Spatia/idle-game-PCB/Graphismes/Background.png

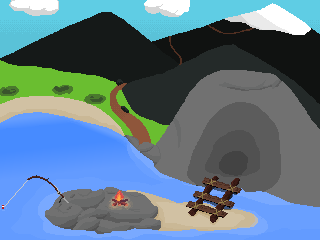
Graphismes/Background.png
