Spatia/idle-game-PCB/Idle_Game_PCB.csv

Reference | Qty | Value | DNP | Exclude from BOM | Exclude from Board | Footprint | Datasheet
BT1 | 1 | Battery_Cell |  |  |  | Connector_JST:JST_PH_S2B-PH-K_1x02_P2.00mm_Horizontal
C1,C16,C20,C21,C22,C23,C24 | 7 | 100nF |  |  |  | Capacitor_SMD:C_0805_2012Metric_Pad1.18x1.45mm_HandSolder
C2,C3 | 2 | 8pF |  |  |  | Capacitor_SMD:C_0805_2012Metric_Pad1.18x1.45mm_HandSolder
C4,C5 | 2 | 18pF |  |  |  | Capacitor_SMD:C_0805_2012Metric_Pad1.18x1.45mm_HandSolder
C6,C18,C19 | 3 | 10uF |  |  |  | Capacitor_SMD:C_0805_2012Metric_Pad1.18x1.45mm_HandSolder
C7,C8,C9,C10,C12 | 5 | 100nF |  |  |  | Capacitor_SMD:C_0603_1608Metric_Pad1.08x0.95mm_HandSolder
C11 | 1 | 2u2 |  |  |  | Capacitor_SMD:C_0603_1608Metric_Pad1.08x0.95mm_HandSolder
C13 | 1 | 1uF |  |  |  | Capacitor_SMD:C_0603_1608Metric_Pad1.08x0.95mm_HandSolder
C14 | 1 | 10nF |  |  |  | Capacitor_SMD:C_0603_1608Metric_Pad1.08x0.95mm_HandSolder
C15,C17 | 2 | 1uF |  |  |  | Capacitor_SMD:C_0805_2012Metric_Pad1.18x1.45mm_HandSolder
F1 | 1 | Polyfuse |  |  |  | Library:1812L010DR
IC1 | 1 | MCP1827S-3302E_EBVAO |  |  |  | Library:MCP1827S3302EEBVAO | https://ww1.microchip.com/downloads/aemDocuments/documents/APID/ProductDocuments/DataSheets/MCP1827-Data-Sheet-DS20002001.pdf
J1 | 1 | FH12A-50S-0.5SH_55_ |  |  |  | Library:FH1250S05SH55_Mirrored | https://www.hirose.com/product/download/?distributor=digikey&type=2d&lang=en&num=FH12A-50S-0.5SH(55)
J2 | 1 | PSP_ADA_444 |  |  |  | Library:PSPADA444
J3 | 1 | FTSH-107-01-L-DV-K-A |  |  |  | Library:FTSH-107-XX-YYY-DV-K-A | http://suddendocs.samtec.com/prints/ftsh-1xx-xx-xxx-dv-xxx-xxx-mkt.pdf
P1 | 1 | USB_C_Plug_USB2.0 |  |  |  | Library:USB_Receptacle | https://www.usb.org/sites/default/files/documents/usb_type-c.zip
Q1,Q2,Q5 | 3 | BSS138 |  |  |  | Package_TO_SOT_SMD:SOT-23 | https://www.onsemi.com/pub/Collateral/BSS138-D.PDF
Q3,Q4 | 2 | NTR4171PT1G |  |  |  | Package_TO_SOT_SMD:SOT-23 | https://www.onsemi.com/pub/Collateral/FDN340P-D.PDF
R1 | 1 | 10kR |  |  |  | Resistor_SMD:R_0805_2012Metric
R2,R3,R4,R6,R7,R8,R9,R10,R11,R12,R13,R17,R21,R22,R32,R33,R34 | 17 | 10kR |  |  |  | Resistor_SMD:R_0805_2012Metric_Pad1.20x1.40mm_HandSolder
R5,R23,R24,R25,R26 | 5 | 0R |  |  |  | Resistor_SMD:R_0805_2012Metric_Pad1.20x1.40mm_HandSolder
R14,R15,R35 | 3 | 5.1kR |  |  |  | Resistor_SMD:R_0805_2012Metric_Pad1.20x1.40mm_HandSolder
R16 | 1 | 2.2kR |  |  |  | Resistor_SMD:R_0805_2012Metric_Pad1.20x1.40mm_HandSolder
R18,R19 | 2 | 10kR |  |  |  | Resistor_SMD:R_0603_1608Metric_Pad0.98x0.95mm_HandSolder
R20 | 1 | 100kR |  |  |  | Resistor_SMD:R_0805_2012Metric_Pad1.20x1.40mm_HandSolder
R27,R28,R29,R30 | 4 | 50R |  |  |  | Resistor_SMD:R_0805_2012Metric_Pad1.20x1.40mm_HandSolder
R31 | 1 | 100R |  |  |  | Resistor_SMD:R_0805_2012Metric_Pad1.20x1.40mm_HandSolder
S1,S2,S3,S4,S5,S6,S7,S8 | 8 | PTS645SH43SMTR92_LFS |  |  |  | Library:PTS645SH43SMTR92LFS | https://www.ckswitches.com/media/1471/pts645.pdf
S9 | 1 | 1825910-6 |  |  |  | Library:18259106 | https://www.ckswitches.com/media/1471/pts645.pdf
TP1 | 1 | VBAT |  |  |  | TestPoint:TestPoint_Pad_D2.0mm
TP2 | 1 | 3V3 |  |  |  | TestPoint:TestPoint_Pad_D2.0mm
TP3 | 1 | GND |  |  |  | TestPoint:TestPoint_Pad_D2.0mm
U1 | 1 | STM32F401RETx |  |  |  | Package_QFP:LQFP-64_10x10mm_P0.5mm | https://www.st.com/resource/en/datasheet/stm32f401re.pdf
U2 | 1 | W25Q128JVS |  |  |  | Package_SO:SOIC-8_5.3x5.3mm_P1.27mm | https://www.winbond.com/resource-files/w25q128jv_dtr%20revc%2003272018%20plus.pdf
U3 | 1 | BQ24075RGT |  |  |  | Package_DFN_QFN:VQFN-16-1EP_3x3mm_P0.5mm_EP1.6x1.6mm | http://www.ti.com/lit/ds/symlink/bq24075.pdf
Y1 | 1 | ECS-120-8-33-JGN-TR |  |  |  | Library:ECS-120-8-33-JGN-TR_ECS | https://ecsxtal.com/store/pdf/ecx-32.pdf
Y3 | 1 | ECS-.327-12.5-16-TR3 |  |  |  | Library:ECS32712534RRTR | https://www.ecsxtal.com/store/pdf/ECX-16.pdf
