Spatia/idle-game-PCB/Lib_SPATIA-F4/3D/ER-TFT024-3-sans-nappe.stp

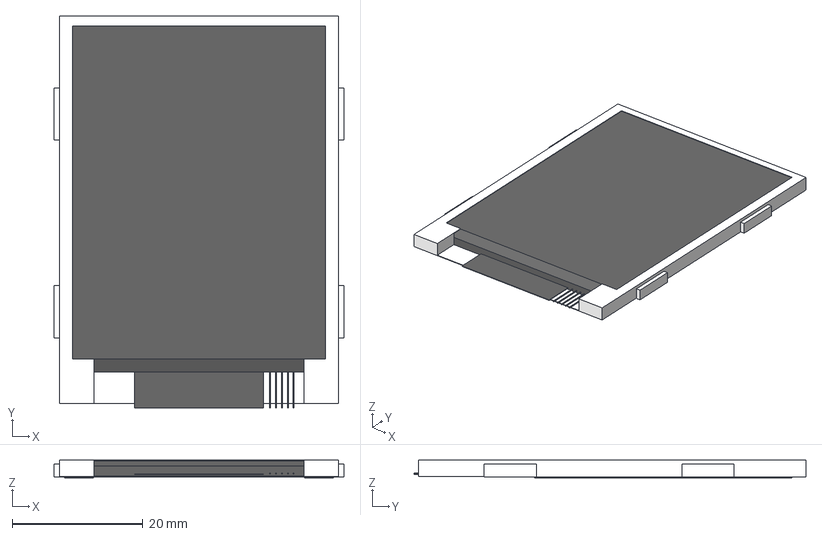
[picture p4: CAD file, 2026-08-21]
Lib_SPATIA-F4/3D/ER-TFT024-3-sans-nappe.stp
44.3 x 60.0 x 2.70 mm
\X2\00BF00C7\X0\
\X2\00BF00C7\X0\--1
\X2\00BF00C7\X0\--2
