Spatia/idle-game-PCB/Lib_SPATIA-F4/3D/jumper.stp

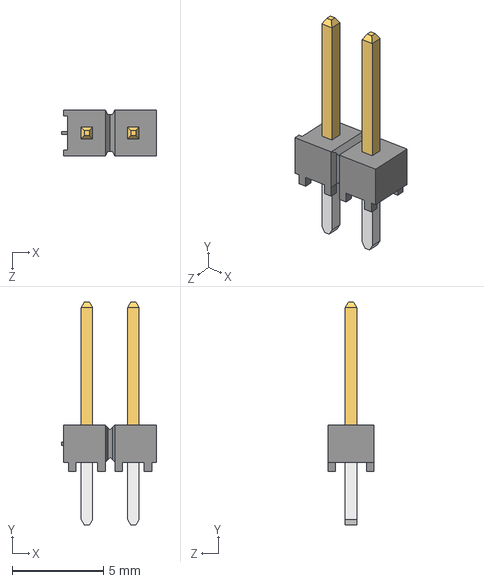
[picture p5: CAD file, 2026-08-21]
Lib_SPATIA-F4/3D/jumper.stp
5.21 x 12.2 x 2.54 mm
T-1S6-17-TSW-1-24-2-S
TSW-102-24-L-S_body
