Spatia/idle-game-PCB/Lib_SPATIA-F4/3D/FH12A-50S-0.5SH_55_.stp

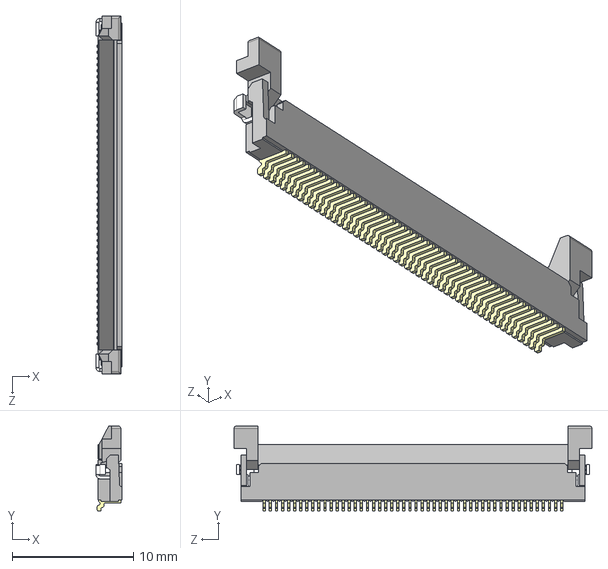
[picture p6: CAD file, 2026-08-21]
Lib_SPATIA-F4/3D/FH12A-50S-0.5SH_55_.stp
2.15 x 7.00 x 29.5 mm
