Spatia/idle-game-PCB/Lib_SPATIA-F4/3D/PTS645SM50-2_LFS.stp

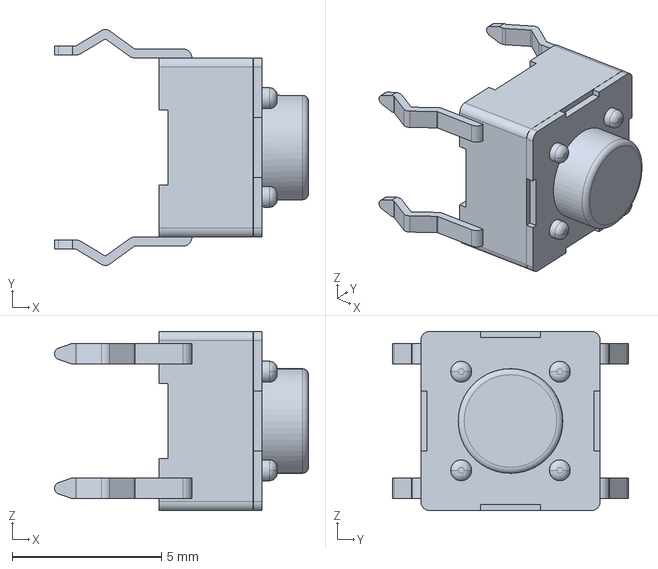
[picture p7: CAD file, 2026-08-21]
Lib_SPATIA-F4/3D/PTS645SM50-2_LFS.stp
8.50 x 7.90 x 6.00 mm
