Spatia/idle-game-PCB/Lib_SPATIA-F4/3D/FTSH-107-01-L-DV-K-A.stp

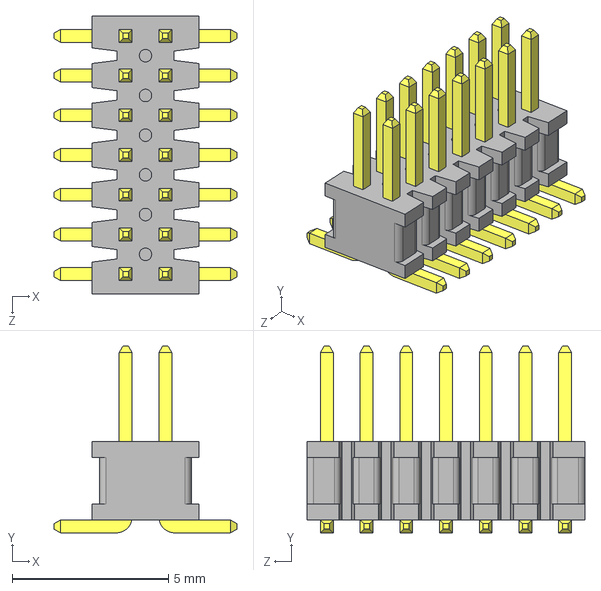
[picture p8: CAD file, 2026-08-21]
Lib_SPATIA-F4/3D/FTSH-107-01-L-DV-K-A.stp
5.84 x 5.97 x 8.89 mm
