Spatia/idle-game-PCB/Lib_SPATIA-F4/3D/CON_UFL001-SMD-T.stp

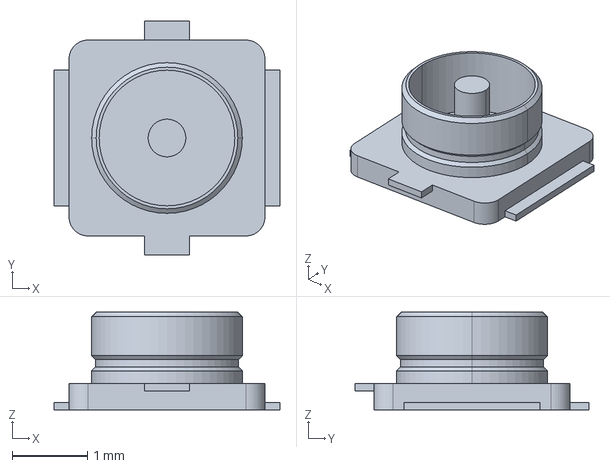
[picture p10: CAD file, 2026-08-21]
Lib_SPATIA-F4/3D/CON_UFL001-SMD-T.stp
3.00 x 3.10 x 1.30 mm
