Spatia/idle-game-PCB/Lib_SPATIA-F4/3D/ER-TFT024-3.stp

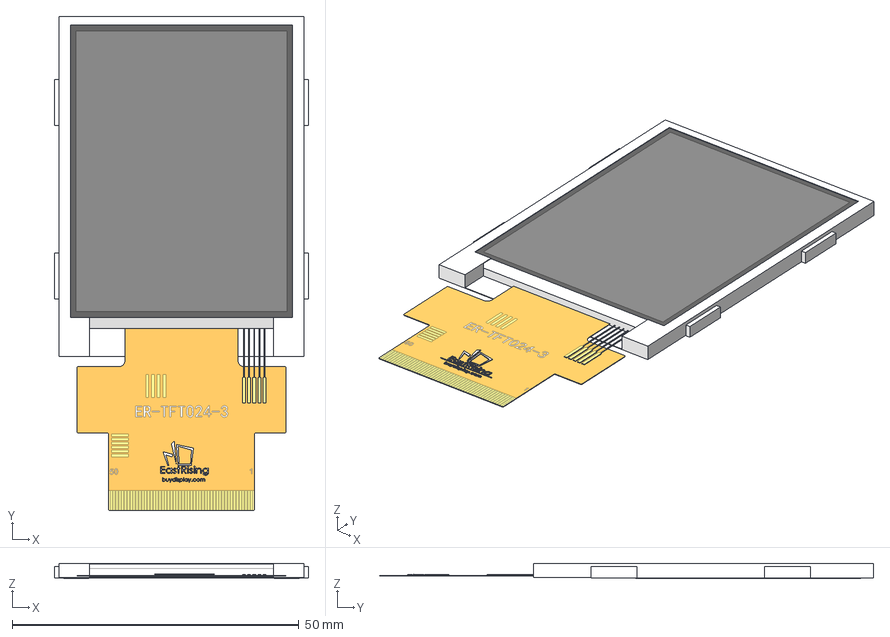
[picture p11: CAD file, 2026-08-21]
Lib_SPATIA-F4/3D/ER-TFT024-3.stp
44.3 x 86.2 x 2.70 mm
¿Ç
¿Ç--1
¿Ç--2
4no_1logo
4no_1logo--1
4no_1logo--2
4no_1logo--3
4no_1logo--4
4no_1logo--5
4no_1logo--6
4no_1logo--7
4no_1logo--8
4no_1logo--9
4no_1logo--10
4no_1logo--11
4no_1logo--12
4no_1logo--13
4no_1logo--14
4no_1logo--15
4no_1logo--16
4no_1logo--17
4no_1logo--18
4no_1logo--19
4no_1logo--20
4no_1logo--21
4no_1logo--22
4no_1logo--23
4no_1logo--24
4no_1logo--25
4no_1logo--26
4no_1logo--27
4no_1logo--28
4no_1logo--29
4no_1logo--30
ER-TFT024-3
