Spatia/idle-game-PCB/Lib_SPATIA-F4/3D/22-05-3041.stp

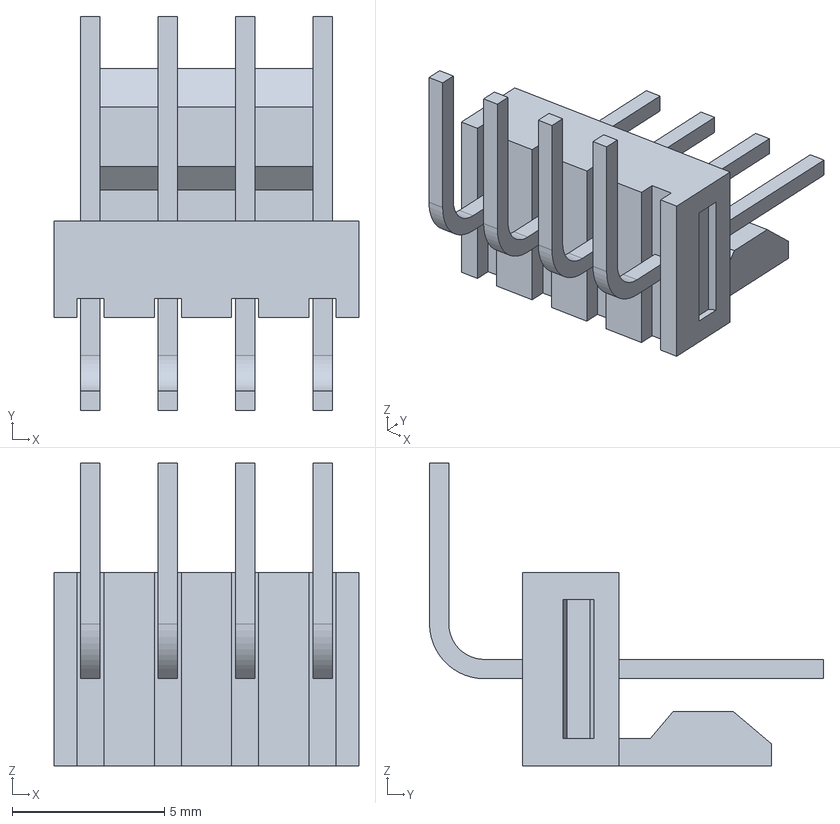
[picture p12: CAD file, 2026-08-21]
Lib_SPATIA-F4/3D/22-05-3041.stp
10.0 x 12.9 x 9.93 mm
