Spatia/idle-game-PCB/Lib_SPATIA-F4/3D/ECS-120-8-33-JGN-TR.stp

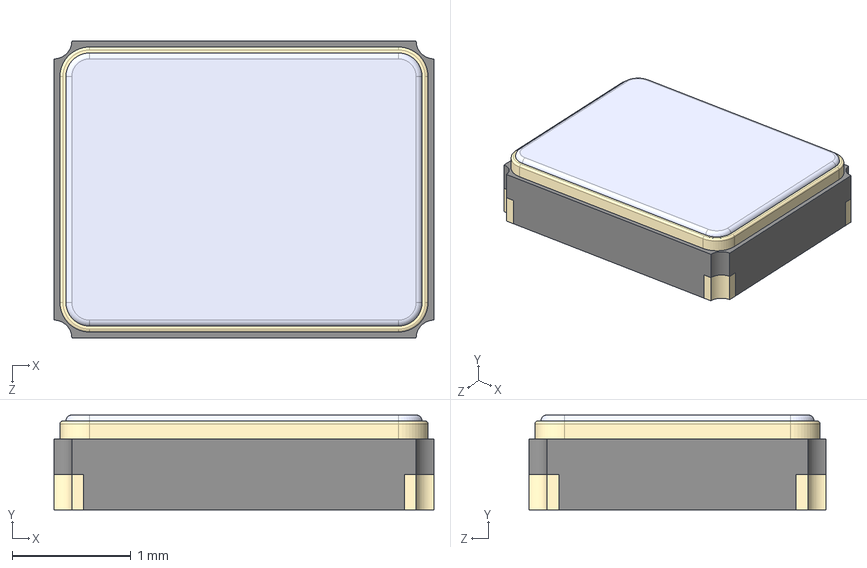
[picture p13: CAD file, 2026-08-21]
Lib_SPATIA-F4/3D/ECS-120-8-33-JGN-TR.stp
3.20 x 0.8 x 2.50 mm
