Spatia/idle-game-PCB/Lib_SPATIA-F4/3D/KP466PXTMA1.stp

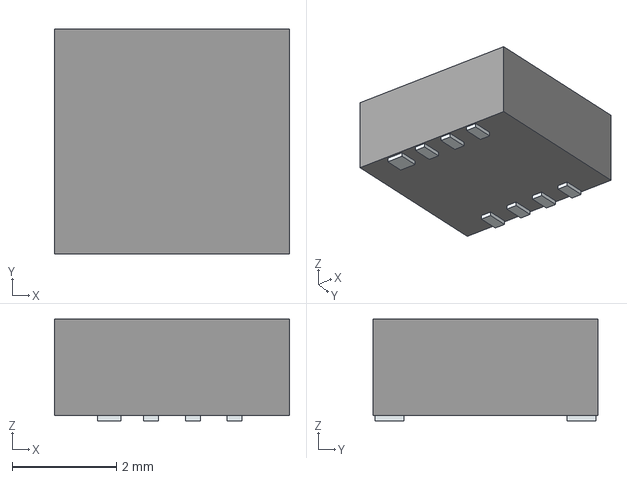
[picture p14: CAD file, 2026-08-21]
Lib_SPATIA-F4/3D/KP466PXTMA1.stp
4.50 x 4.30 x 1.95 mm
Pins
