Spatia/idle-game-PCB/Lib_SPATIA-F4/3D/ECS-.327-12.5-16-TR3.stp

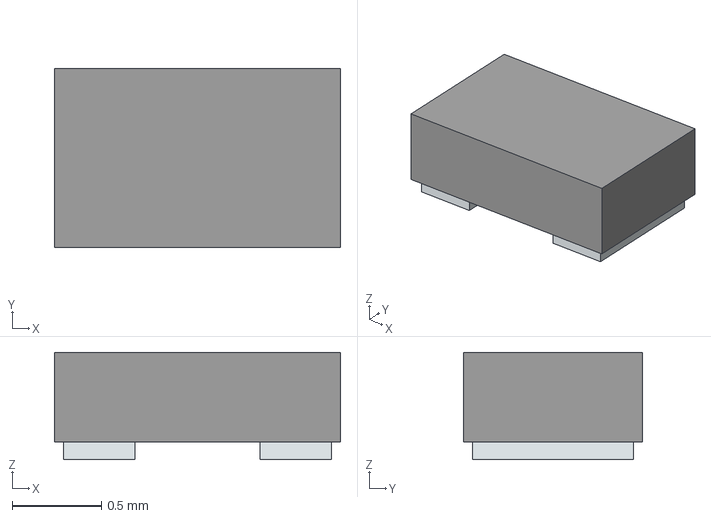
[picture p15: CAD file, 2026-08-21]
Lib_SPATIA-F4/3D/ECS-.327-12.5-16-TR3.stp
1.60 x 1.00 x 0.6 mm
Pins
