Spatia/idle-game-PCB/Lib_SPATIA-F4/3D/SMA_coude.stp

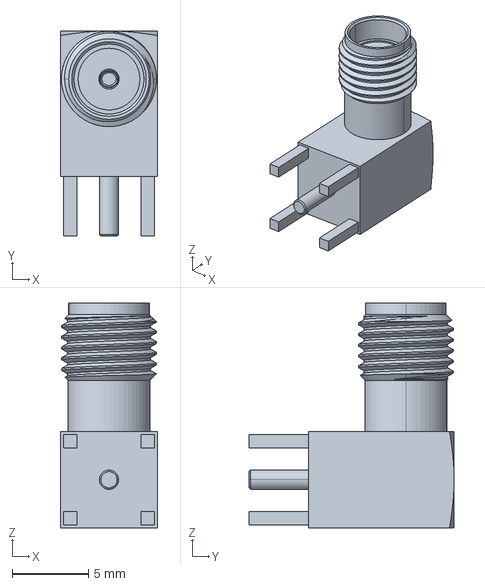
[picture p16: CAD file, 2026-08-21]
Lib_SPATIA-F4/3D/SMA_coude.stp
6.35 x 13.5 x 14.8 mm
