Spatia/idle-game-PCB/Lib_SPATIA-F4/3D/MCP1827S-3302E_EB.stp

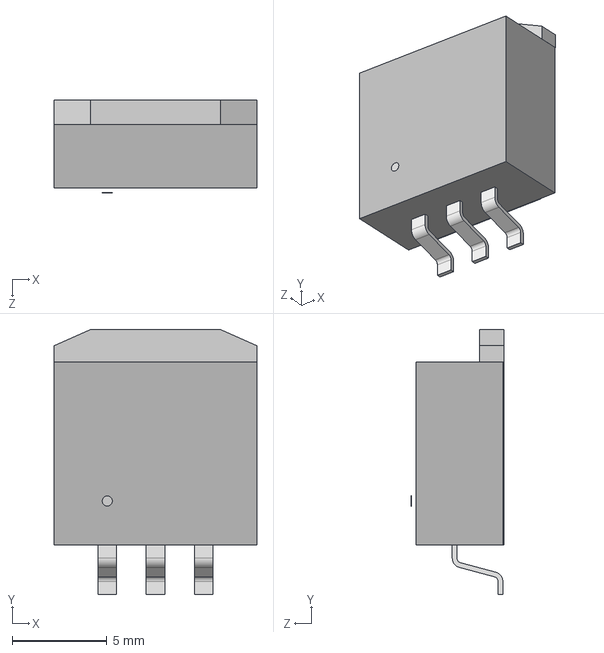
[picture p17: CAD file, 2026-08-21]
Lib_SPATIA-F4/3D/MCP1827S-3302E_EB.stp
10.7 x 14.0 x 4.88 mm
