Spatia/idle-game-PCB/Lib_SPATIA-F4/3D/ECS-.327-6-34RR-TR.stp

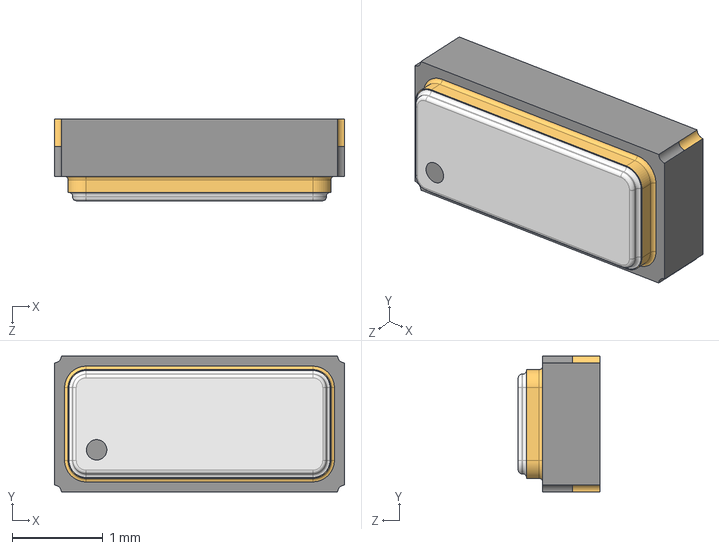
[picture p18: CAD file, 2026-08-21]
Lib_SPATIA-F4/3D/ECS-.327-6-34RR-TR.stp
3.20 x 1.50 x 0.9 mm
