Spatia/idle-game-PCB/Lib_SPATIA-F4/3D/USB4105-GF-A.stp

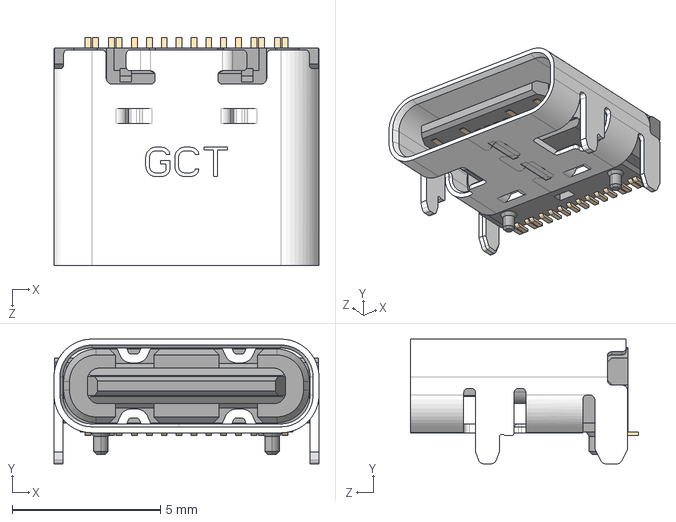
[picture p19: CAD file, 2026-08-21]
Lib_SPATIA-F4/3D/USB4105-GF-A.stp
8.94 x 4.21 x 7.70 mm
HSG_默认
