Spatia/idle-game-PCB/Lib_SPATIA-F4/3D/NTR4171PT1G.stp

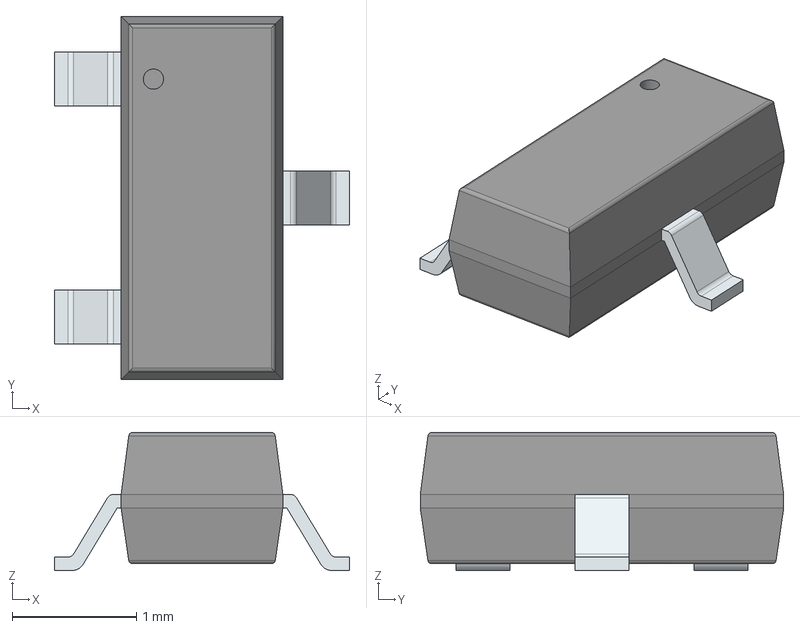
[picture p20: CAD file, 2026-08-21]
Lib_SPATIA-F4/3D/NTR4171PT1G.stp
2.37 x 2.92 x 1.11 mm
PinsArrayL
FilletPinR
