Spatia/idle-game-PCB/Lib_SPATIA-F4/3D/BAT54W-G3-18.stp

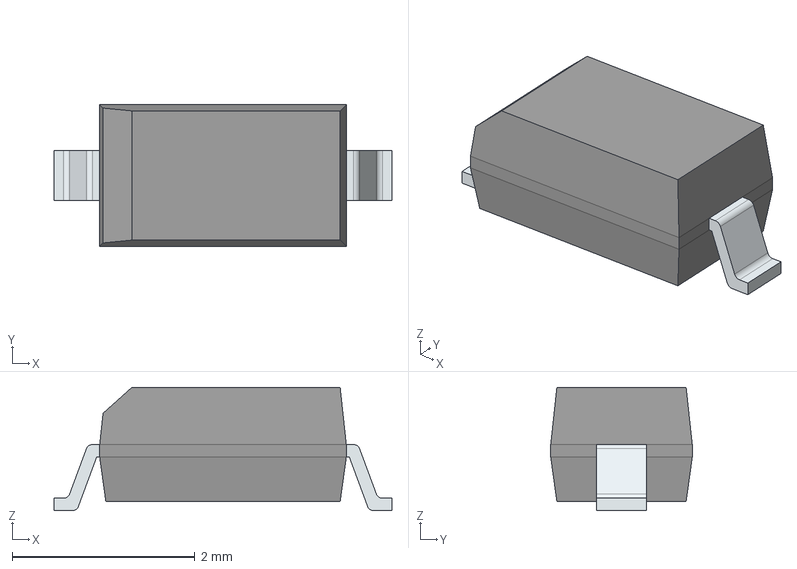
[picture p21: CAD file, 2026-08-21]
Lib_SPATIA-F4/3D/BAT54W-G3-18.stp
3.70 x 1.55 x 1.35 mm
FilletPinL
FilletPinR
