Spatia/idle-game-PCB/Lib_SPATIA-F4/3D/USB4085-GF-A.stp

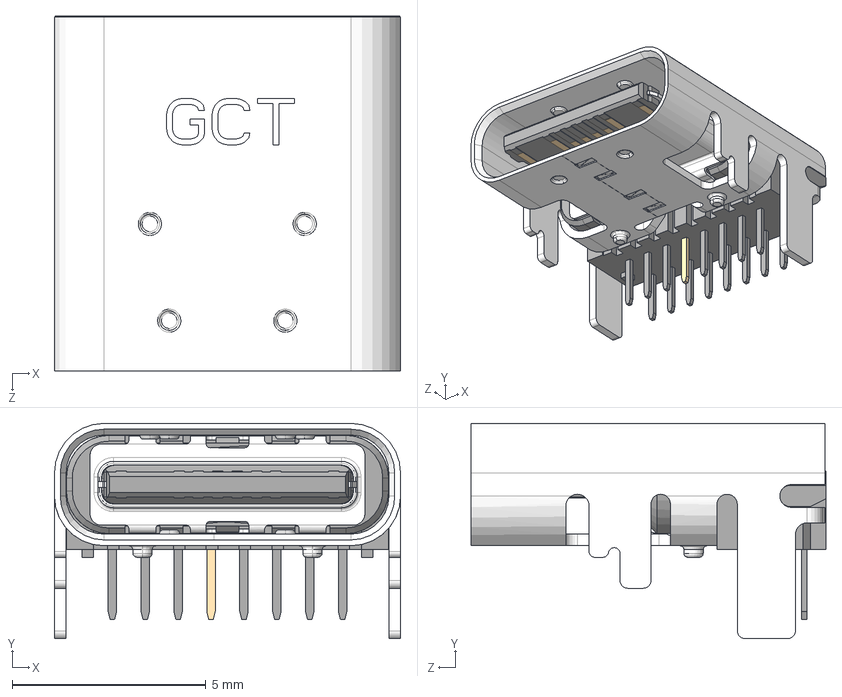
[picture p22: CAD file, 2026-08-21]
Lib_SPATIA-F4/3D/USB4085-GF-A.stp
8.94 x 5.56 x 9.17 mm
USB4085-GF-A_PART3
USB4085-GF-A_PART2
USB4085-GF-A_PART1
