Spatia/idle-game-PCB/Lib_SPATIA-F4/3D/PTS645SL70SMTR92_LFS.stp

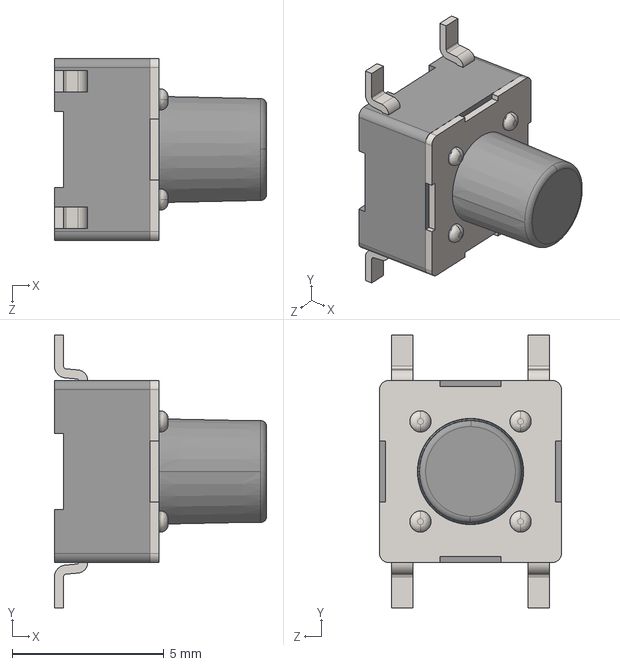
[picture p23: CAD file, 2026-08-21]
Lib_SPATIA-F4/3D/PTS645SL70SMTR92_LFS.stp
7.00 x 9.00 x 6.00 mm
