Spatia/idle-game-PCB/Lib_SPATIA-F4/3D/pile btn.stp

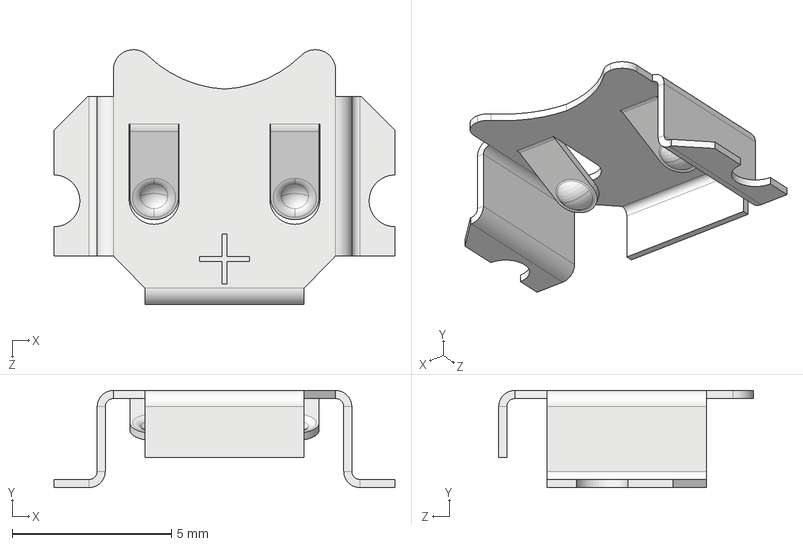
[picture p24: CAD file, 2026-08-21]
Lib_SPATIA-F4/3D/pile btn.stp
10.7 x 3.05 x 8.00 mm
