Spatia/idle-game-PCB/Lib_SPATIA-F4/3D/FH12-50S-0.5SH_55_.stp

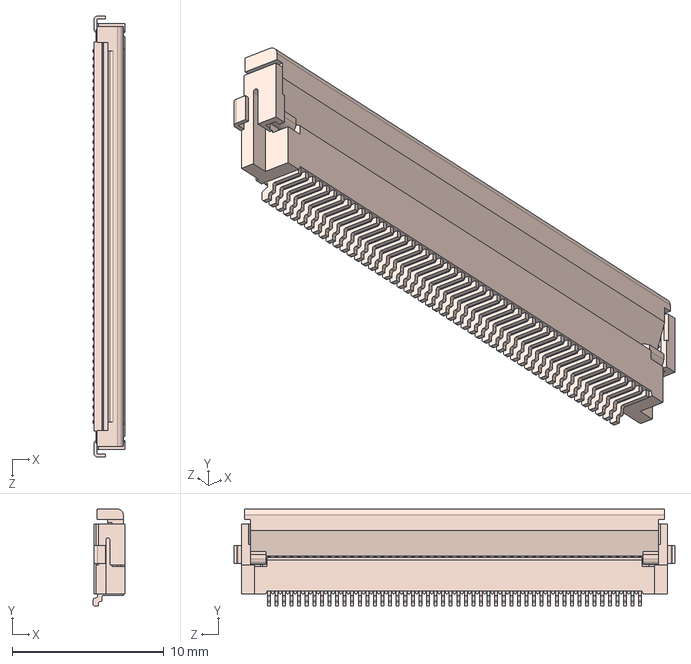
[picture p25: CAD file, 2026-08-21]
Lib_SPATIA-F4/3D/FH12-50S-0.5SH_55_.stp
2.10 x 6.40 x 29.1 mm
