Spatia/idle-game-PCB/(list of files, cad)

Other CAD files:
Lib_SPATIA-F4/3D/1812L260_16MR.stp
Lib_SPATIA-F4/3D/1825910-6.stp
Lib_SPATIA-F4/3D/53048-0810.stp
