Spatia/idle-game-PCB/Idle_Game_PCB.pdf

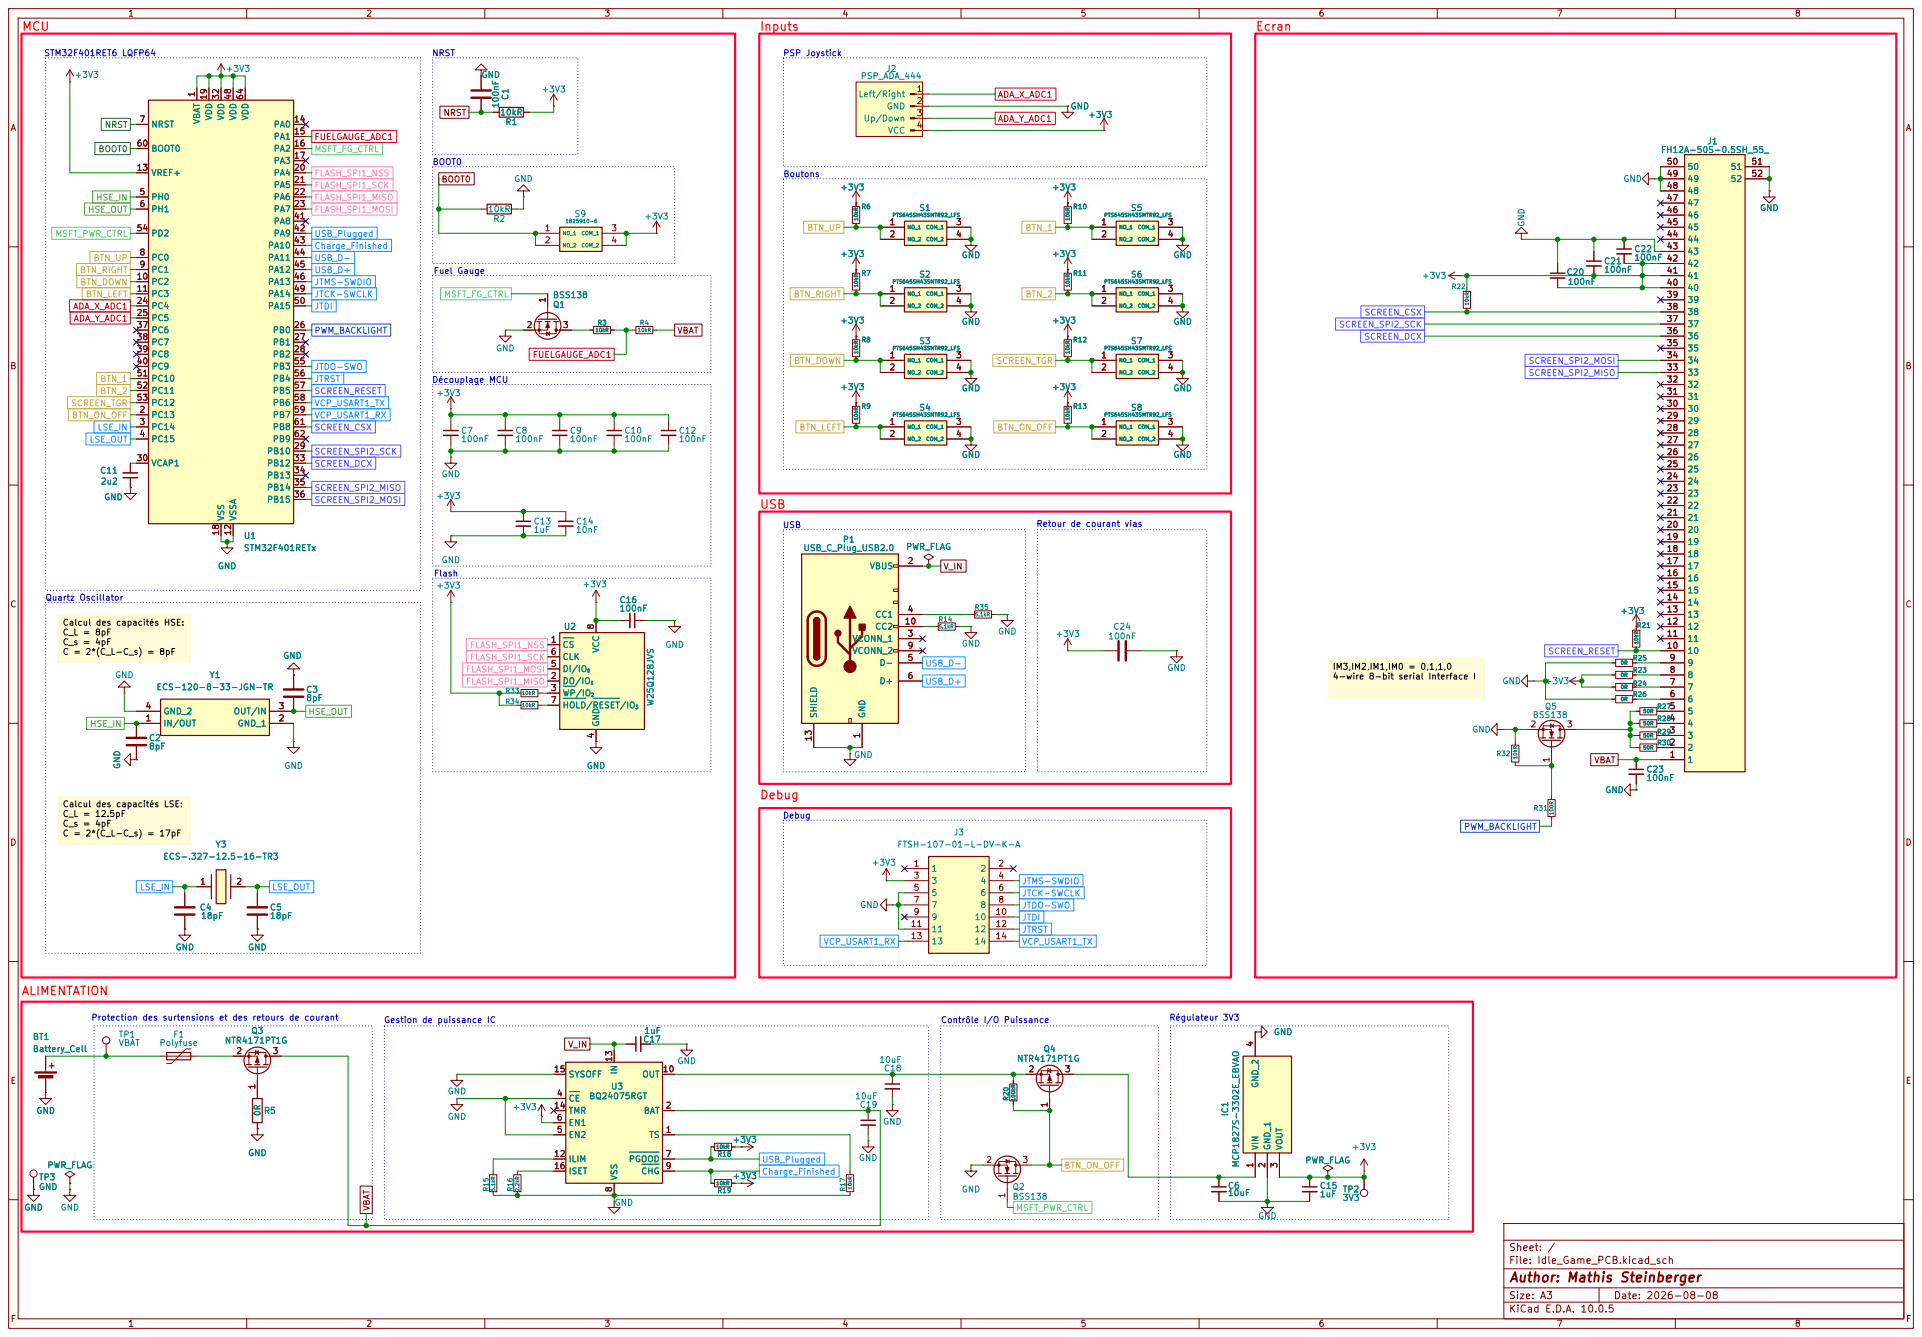
[picture p26: page 1]

Left/Right 1 GND 2 Up/Down 3

Retour de courant vias

4 DI/IO0 5 CLK 6 HOLD/RESET/IO3 7 VCC U2 8 W25Q128JVS +3V3 GND R16 2.2kR +3V3

4-wire 8-bit serial Interface I Calcul des capacités HSE: C_L = 8pF C_s = 4pF C = 2*(C_L-C_s) = 8pF Calcul des capacités LSE: C_L = 12.5pF C_s = 4pF C = 2*(C_L-C_s) = 17pF

4 DI/IO0 5 CLK 6 HOLD/RESET/IO3 7 VCC

Protection des surtensions et des retours de courant

Gestion de puissance IC
