Spatia/idle-game-PCB/Idle_Game_PCB.kicad_pcb

## KiCad design Idle_Game_PCB.kicad_pcb (2026-10-20)

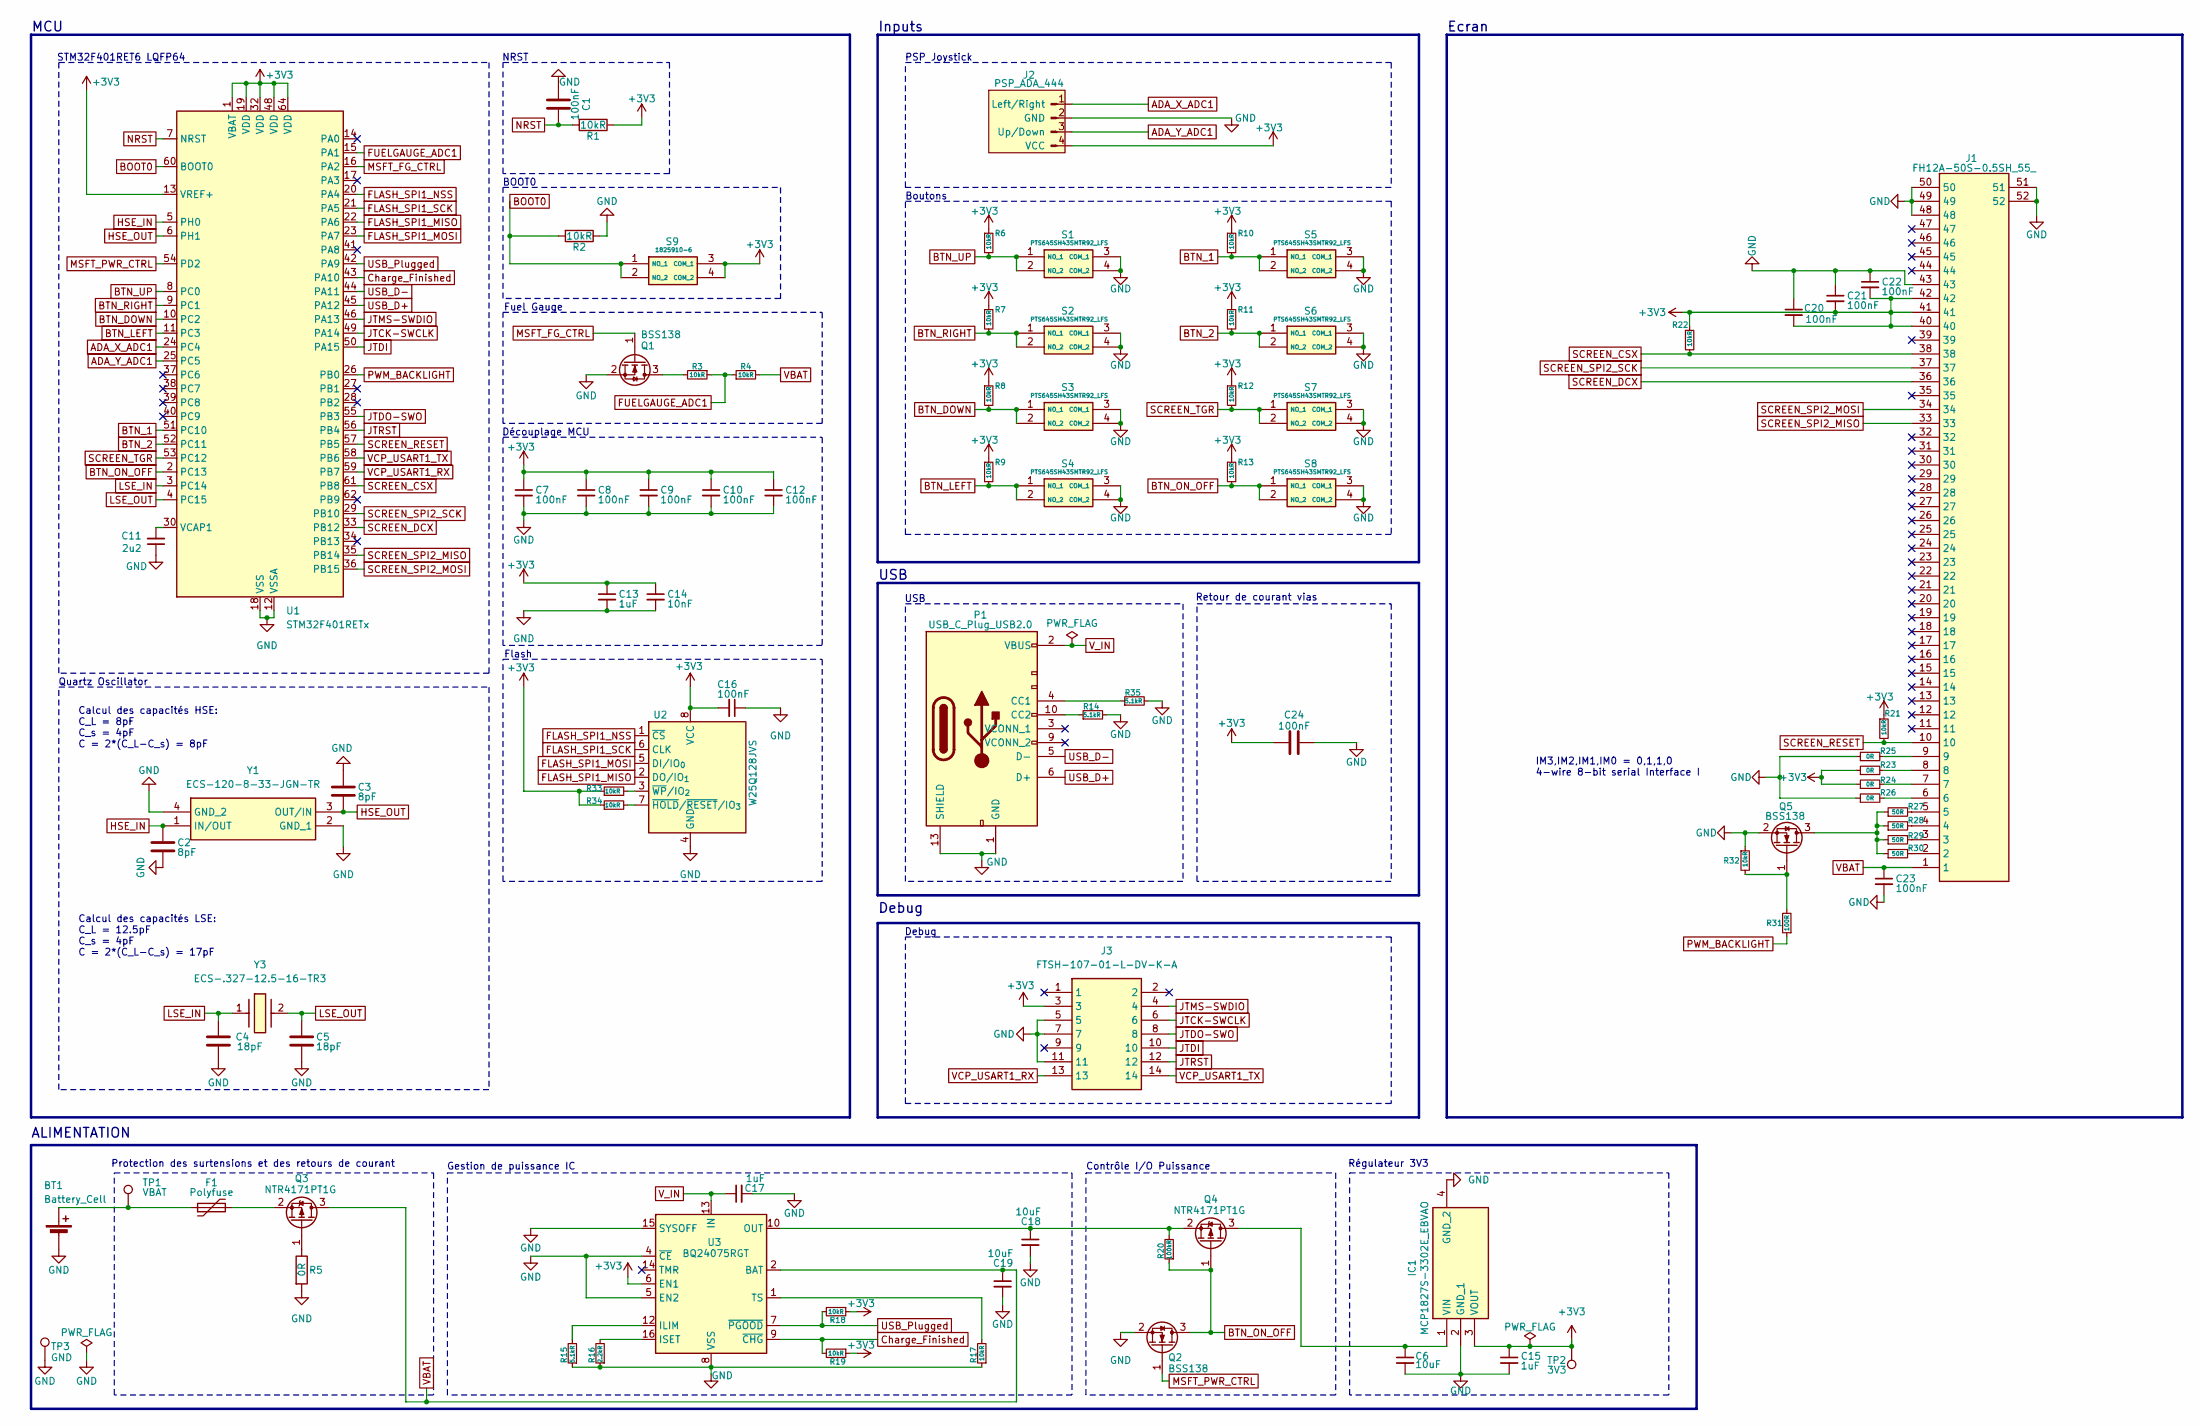
[picture p27: schematic Idle_Game_PCB.kicad_sch, Mathis Steinberger]

Parts:
BT1: Battery_Cell; JST_PH_S2B-PH-K_1x02_P2.00mm_Horizontal
C1, C16, C20, C21, C22, C23, C24: 100nF; C_0805_2012Metric_Pad1.18x1.45mm_HandSolder
C2, C3: 8pF; C_0805_2012Metric_Pad1.18x1.45mm_HandSolder
C4, C5: 18pF; C_0805_2012Metric_Pad1.18x1.45mm_HandSolder
C6, C18, C19: 10uF; C_0805_2012Metric_Pad1.18x1.45mm_HandSolder
C7, C8, C9, C10, C12: 100nF; C_0603_1608Metric_Pad1.08x0.95mm_HandSolder
C11: 2u2; C_0603_1608Metric_Pad1.08x0.95mm_HandSolder
C13: 1uF; C_0603_1608Metric_Pad1.08x0.95mm_HandSolder
C14: 10nF; C_0603_1608Metric_Pad1.08x0.95mm_HandSolder
C15, C17: 1uF; C_0805_2012Metric_Pad1.18x1.45mm_HandSolder
F1: Polyfuse; 1812L010DR
IC1: MCP1827S-3302E_EBVAO; MCP1827S3302EEBVAO; Manufacturer_Part_Number MCP1827S-3302E/EBVAO
J1: FH12A-50S-0.5SH_55_; FH1250S05SH55_Mirrored; Mouser Part Number 798-FH12A-50S0.5SH55
J2: PSP_ADA_444; PSPADA444
J3: FTSH-107-01-L-DV-K-A; FTSH-107-XX-YYY-DV-K-A; Mouser Part Number 200-FTSH10701LDVKA
P1: USB_C_Plug_USB2.0; USB_Receptacle
Q1, Q2, Q5: BSS138; SOT-23
Q3, Q4: NTR4171PT1G; SOT-23
R1: 10kR; R_0805_2012Metric
R2, R3, R4, R6, R7, R8, R9, R10, R11, R12, R13, R17, R21, R22, R32, R33, R34: 10kR; R_0805_2012Metric_Pad1.20x1.40mm_HandSolder
R5, R23, R24, R25, R26: 0R; R_0805_2012Metric_Pad1.20x1.40mm_HandSolder
R14, R15, R35: 5.1kR; R_0805_2012Metric_Pad1.20x1.40mm_HandSolder
R16: 2.2kR; R_0805_2012Metric_Pad1.20x1.40mm_HandSolder
R18, R19: 10kR; R_0603_1608Metric_Pad0.98x0.95mm_HandSolder
R20: 100kR; R_0805_2012Metric_Pad1.20x1.40mm_HandSolder
R27, R28, R29, R30: 50R; R_0805_2012Metric_Pad1.20x1.40mm_HandSolder
R31: 100R; R_0805_2012Metric_Pad1.20x1.40mm_HandSolder
S1, S2, S3, S4, S5, S6, S7, S8: PTS645SH43SMTR92_LFS; PTS645SH43SMTR92LFS; Manufacturer_Part_Number PTS645SH43SMTR92 LFS
S9: 1825910-6; 18259106; Manufacturer_Part_Number PTS645SH43SMTR92 LFS
TP1: VBAT; TestPoint_Pad_D2.0mm
TP2: 3V3; TestPoint_Pad_D2.0mm
TP3: GND; TestPoint_Pad_D2.0mm
U1: STM32F401RETx; LQFP-64_10x10mm_P0.5mm
U2: W25Q128JVS; SOIC-8_5.3x5.3mm_P1.27mm
U3: BQ24075RGT; VQFN-16-1EP_3x3mm_P0.5mm_EP1.6x1.6mm
Y1: ECS-120-8-33-JGN-TR; ECS-120-8-33-JGN-TR_ECS; Mouser Part Number 520-120-8-33-JGNT
Y3: ECS-.327-12.5-16-TR3; ECS32712534RRTR; Mouser Part Number 520-ECS.32712.516TR3

Connections:
+3V3: C7.1, C8.1, C9.1, C10.1, C12.1, C13.1, C14.1, C15.1, C16.2, C20.2, C21.2, C22.2, C24.1, IC1.3 (VOUT), J1.40, J1.41, J1.42, J2.4 (VCC), J3.3, R1.1, R6.1, R7.1, R8.1, R9.1, R10.1, R11.1, R12.1, R13.1, R18.1, R19.1, R21.1, R22.1, R23.1, R24.1, R33.1, R34.1, S9.3 (COM_1), S9.4 (COM_2), TP2.1 (1_1), U1.1 (VBAT), U1.13 (VREF+), U1.19 (VDD), U1.32 (VDD), U1.48 (VDD), U1.64 (VDD), U2.8 (VCC), U3.6 (EN1)
ADA_X_ADC1: J2.1 (Left/Right), U1.24 (PC4)
ADA_Y_ADC1: J2.3 (Up/Down), U1.25 (PC5)
BOOT0: R2.2, S9.1 (NO_1), S9.2 (NO_2), U1.60 (BOOT0)
BTN_1: R10.2, S5.1 (NO_1), S5.2 (NO_2), U1.51 (PC10)
BTN_2: R11.2, S6.1 (NO_1), S6.2 (NO_2), U1.52 (PC11)
BTN_DOWN: R8.2, S3.1 (NO_1), S3.2 (NO_2), U1.10 (PC2)
BTN_LEFT: R9.2, S4.1 (NO_1), S4.2 (NO_2), U1.11 (PC3)
BTN_ON_OFF: Q2.3 (D), Q4.1 (G), R13.2, R20.1, S8.1 (NO_1), S8.2 (NO_2), U1.2 (PC13)
BTN_RIGHT: R7.2, S2.1 (NO_1), S2.2 (NO_2), U1.9 (PC1)
BTN_UP: R6.2, S1.1 (NO_1), S1.2 (NO_2), U1.8 (PC0)
Charge_Finished: R19.2, U1.43 (PA10), U3.9 (~CHG)
FLASH_SPI1_MISO: U1.22 (PA6), U2.2 (DO/IO_{1})
FLASH_SPI1_MOSI: U1.23 (PA7), U2.5 (DI/IO_{0})
FLASH_SPI1_NSS: U1.20 (PA4), U2.1 (~CS)
FLASH_SPI1_SCK: U1.21 (PA5), U2.6 (CLK)
FUELGAUGE_ADC1: R3.1, R4.1, U1.15 (PA1)
GND: BT1.2 (-), C1.1, C2.2, C3.2, C4.2, C5.2, C6.2, C7.2, C8.2, C9.2, C10.2, C11.1, C12.2, C13.2, C14.2, C15.2, C16.1, C17.2, C18.2, C19.2, C20.1, C21.1, C22.1, C23.2, C24.2, IC1.2 (GND_1), IC1.4 (GND_2), J1.43, J1.48, J1.49, J1.50, J1.51, J1.52, J2.2 (GND), J3.5, J3.7, J3.11, P1.1 (GND), P1.12 (GND), P1.13 (SHIELD), P1.14 (SHIELD), P1.15 (SHIELD), P1.16 (SHIELD), Q1.2 (S), Q2.2 (S), Q5.2 (S), R2.1, R5.2, R14.2, R15.1, R16.1, R17.1, R25.1, R26.1, R32.1, R35.2, S1.3 (COM_1), S1.4 (COM_2), S2.3 (COM_1), S2.4 (COM_2), S3.3 (COM_1), S3.4 (COM_2), S4.3 (COM_1), S4.4 (COM_2), S5.3 (COM_1), S5.4 (COM_2), S6.3 (COM_1), S6.4 (COM_2), S7.3 (COM_1), S7.4 (COM_2), S8.3 (COM_1), S8.4 (COM_2), TP3.1 (1_1), U1.12 (VSSA), U1.18 (VSS), U1.31 (VSS), U1.47 (VSS), U1.63 (VSS), U2.4 (GND), U3.4 (~CE), U3.5 (EN2), U3.8 (VSS), U3.15 (SYSOFF), U3.17 (VSS), Y1.2 (GND_1), Y1.4 (GND_2)
HSE_IN: C2.1, U1.5 (PH0), Y1.1 (IN/OUT)
HSE_OUT: C3.1, U1.6 (PH1), Y1.3 (OUT/IN)
JTCK-SWCLK: J3.6, U1.49 (PA14)
JTDI: J3.10, U1.50 (PA15)
JTDO-SWO: J3.8, U1.55 (PB3)
JTMS-SWDIO: J3.4, U1.46 (PA13)
JTRST: J3.12, U1.56 (PB4)
LSE_IN: C4.1, U1.3 (PC14), Y3.1
LSE_OUT: C5.1, U1.4 (PC15), Y3.2
MSFT_FG_CTRL: Q1.1 (G), U1.16 (PA2)
MSFT_PWR_CTRL: Q2.1 (G), U1.54 (PD2)
NRST: C1.2, R1.2, U1.7 (NRST)
unnamed: BT1.1 (+), F1.1, TP1.1 (1_1)
unnamed: C6.1, IC1.1 (VIN), Q4.3 (D)
unnamed: J1.2, R30.2
unnamed: J1.3, R29.2
unnamed: J1.4, R28.2
unnamed: J1.5, R27.2
unnamed: J1.6, R26.2
unnamed: J1.7, R24.2
unnamed: J1.8, R23.2
unnamed: J1.9, R25.2
unnamed: P1.4 (CC1), R35.1
unnamed: P1.10 (CC2), R14.1
unnamed: Q1.3 (D), R3.2
unnamed: Q3.1 (G), R5.1
unnamed: F1.2, Q3.2 (S)
unnamed: C18.1, Q4.2 (S), R20.2, U3.10 (OUT), U3.11 (OUT)
unnamed: Q5.3 (D), R27.1, R28.1, R29.1, R30.1
unnamed: Q5.1 (G), R31.2, R32.2
unnamed: C11.2, U1.30 (VCAP1)
unnamed: R34.2, U2.7 (~HOLD/~RESET/IO_{3})
unnamed: R33.2, U2.3 (~WP/IO_{2})
unnamed: R15.2, U3.12 (ILIM)
unnamed: R16.2, U3.16 (ISET)
unnamed: R17.2, U3.1 (TS)
PWM_BACKLIGHT: R31.1, U1.26 (PB0)
SCREEN_CSX: J1.38, R22.2, U1.61 (PB8)
SCREEN_DCX: J1.36, U1.33 (PB12)
SCREEN_RESET: J1.10, R21.2, U1.57 (PB5)
SCREEN_SPI2_MISO: J1.33, U1.35 (PB14)
SCREEN_SPI2_MOSI: J1.34, U1.36 (PB15)
SCREEN_SPI2_SCK: J1.37, U1.29 (PB10)
SCREEN_TGR: R12.2, S7.1 (NO_1), S7.2 (NO_2), U1.53 (PC12)
USB_D+: P1.6 (D+), P1.8 (D+), U1.45 (PA12)
USB_D-: P1.5 (D-), P1.7 (D-), U1.44 (PA11)
USB_Plugged: R18.2, U1.42 (PA9), U3.7 (~PGOOD)
VBAT: C19.1, C23.1, J1.1, Q3.3 (D), R4.2, U3.2 (BAT), U3.3 (BAT)
VCP_USART1_RX: J3.13, U1.59 (PB7)
VCP_USART1_TX: J3.14, U1.58 (PB6)
V_IN: C17.1, P1.2 (VBUS), P1.11 (VBUS), U3.13 (IN)

Notes on the sheet:
ALIMENTATION
STM32F401RET6 LQFP64
Protection des surtensions et des retours de courant
NRST
MCU
Contrôle I/O Puissance
Régulateur 3V3
Fuel Gauge
USB
Boutons
Gestion de puissance IC
Debug
BOOT0
Inputs
Ecran
Flash
Quartz Oscillator
PSP Joystick
Découplage MCU
Retour de courant vias
IM3,IM2,IM1,IM0 = 0,1,1,0 4-wire 8-bit serial Interface I
Calcul des capacités LSE: C_L = 12.5pF C_s = 4pF C = 2*(C_L-C_s) = 17pF
Calcul des capacités HSE: C_L = 8pF C_s = 4pF C = 2*(C_L-C_s) = 8pF

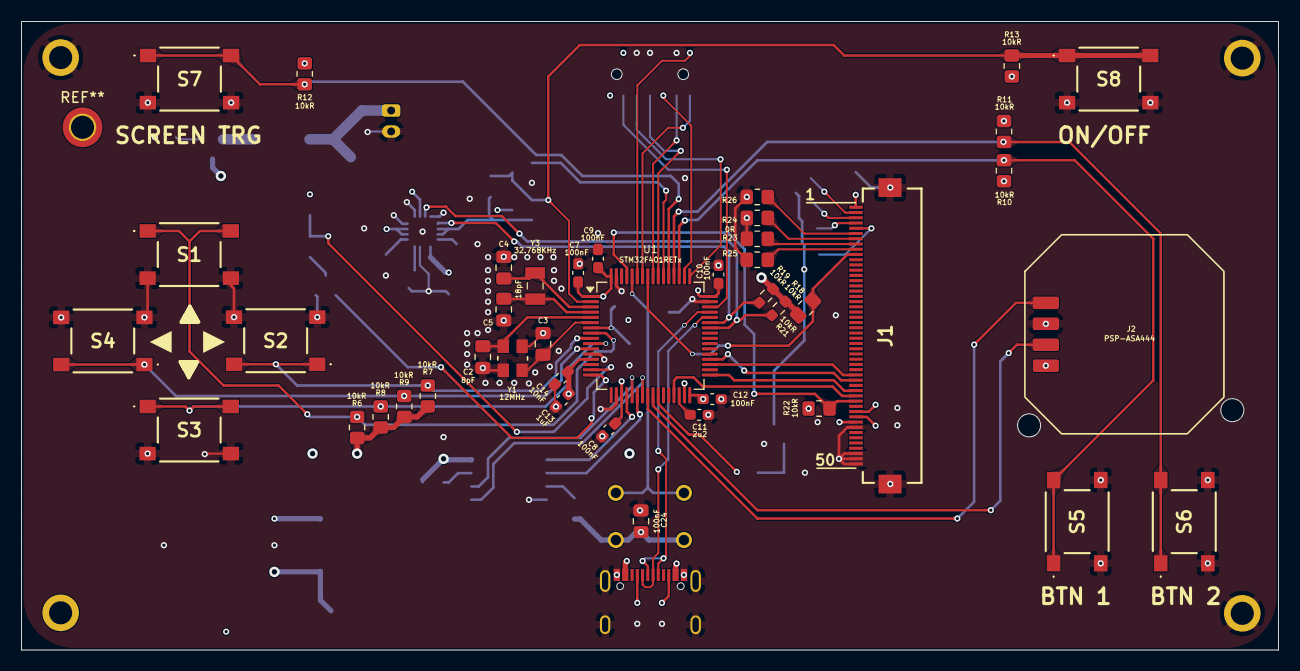
[picture p28: board Idle_Game_PCB.kicad_pcb from above]

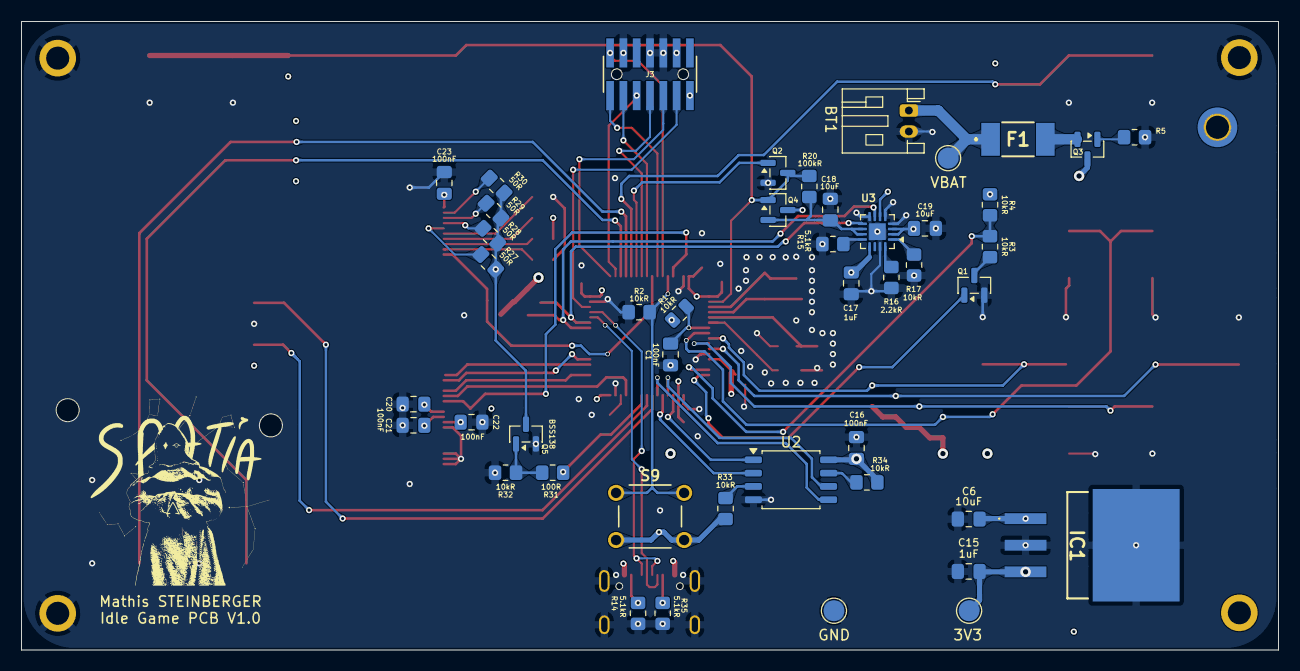
[picture p29: board Idle_Game_PCB.kicad_pcb from below]

Board: 4 copper layers, 120.0 x 60.0 mm, 92 parts (45 on the bottom side), 69 nets.

Other parts of the board:
Trou_Bas_Droite: MountingHole_2.2mm_M2
Trou_Bas_Gauche: MountingHole_2.2mm_M2
Trou_Haut_Droite: MountingHole_2.2mm_M2
Trou_Haut_Gauche: MountingHole_2.2mm_M2
