Spatia/idle-game-PCB/(commit log)

2026-08-21 init: Hardware
    [1812L260_16MR.stp, 1825910-6.stp, 22-05-3041.stp, 53048-0810.stp, BAT54W-G3-18.stp, CON_UFL001-SMD-T.stp, ECS-.327-12.5-16-TR3.stp, ECS-.327-6-34RR-TR.stp]
2026-08-21 cleaning gerbers
    [Idle_Game_PCB-B_Cu.gbr, Idle_Game_PCB-B_Mask.gbr, Idle_Game_PCB-B_Paste.gbr, Idle_Game_PCB-B_Silkscreen.gbr, Idle_Game_PCB-Edge_Cuts.gbr, Idle_Game_PCB-F_Cu.gbr, Idle_Game_PCB-F_Mask.gbr, Idle_Game_PCB-F_Paste.gbr]
2026-10-20 update for future PCB version
    [Idle_Game_PCB.kicad_pcb, Idle_Game_PCB.kicad_sch]
